yuhao-kuo/goose45/README.md

# Goose45

Goose45 is a 45% keyboard project.
