yuhao-kuo/goose45/case/goose45case_top_v10.FCStd

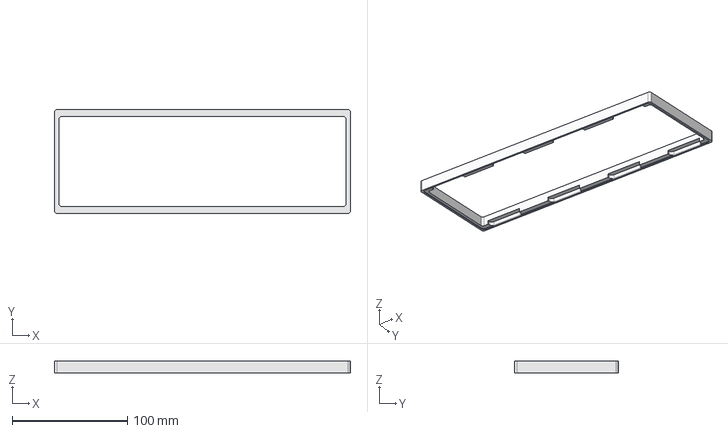
[picture p1: CAD file, 2023-12-30]
case/goose45case_top_v10.FCStd
257.0 x 90.0 x 10.0 mm
