yuhao-kuo/goose45/case/goose45case_class_v10.FCStd

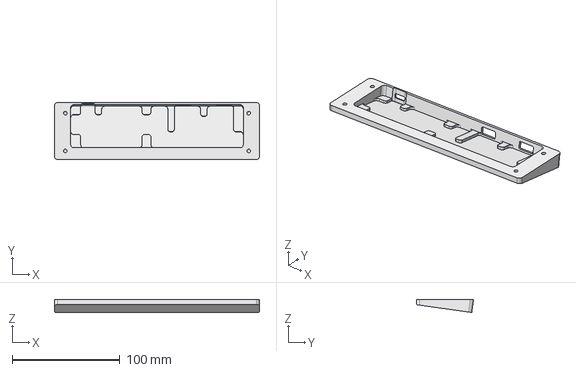
[picture p2: CAD file, 2023-12-30]
case/goose45case_class_v10.FCStd
190.0 x 53.0 x 12.0 mm
