yuhao-kuo/goose45/case/goose45case_bottom_v10.FCStd

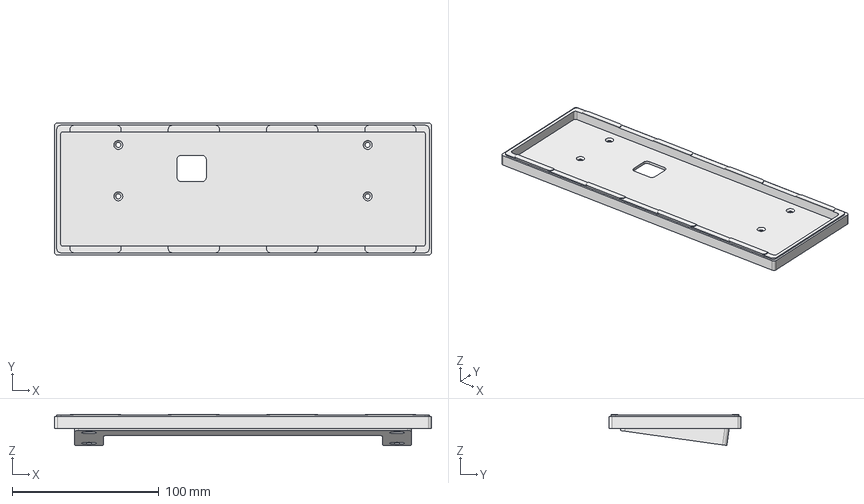
[picture p3: CAD file, 2023-12-30]
case/goose45case_bottom_v10.FCStd
257.0 x 90.0 x 21.2 mm
