yuhao-kuo/goose45/case/goose45case_plate_v10.FCStd

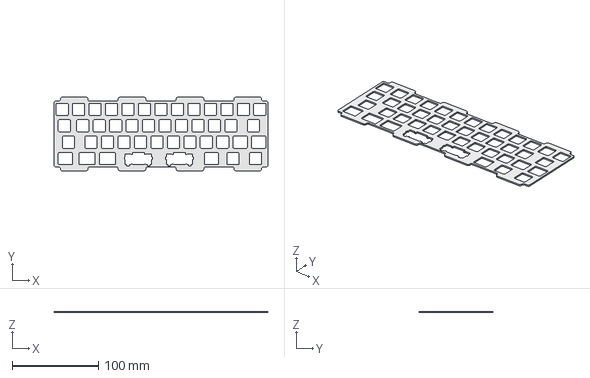
[picture p4: CAD file, 2023-12-30]
case/goose45case_plate_v10.FCStd
247.6 x 85.2 x 1.50 mm
