yuhao-kuo/goose45/case/goose45case_group.FCStd

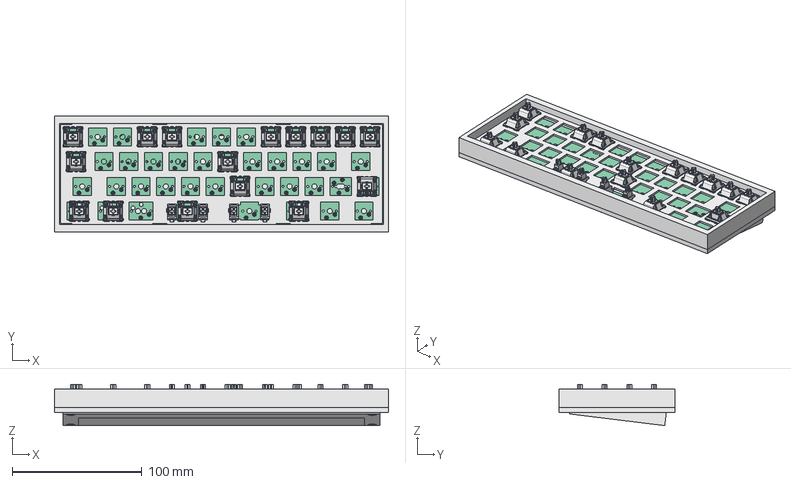
[picture p5: CAD file, 2023-02-15]
case/goose45case_group.FCStd
257.0 x 89.6 x 31.7 mm
Pcb_17d010
C6_C_1206_3216Metric_ad6b6205d722 x 4
R5_R_0603_1608Metric_66f7f9a4a4d005 x 4
C1_C_0603_1608Metric_e906ab7ae621 x 7
J2_Molex_53261_0571_cd36a31aba027 x 3
C13_CP_EIA_7343_30_AVX_N_2c1bf9caf20f001 x 4
USB Type C Port (SMD Type)067
USB Type C Port (SMD Type)059
USB Type C Port (SMD Type)048
USB Type C Port (SMD Type)061
USB Type C Port (SMD Type)062
USB Type C Port (SMD Type)060
USB Type C Port (SMD Type)063
USB Type C Port (SMD Type)055
USB Type C Port (SMD Type)054
USB Type C Port (SMD Type)069
USB Type C Port (SMD Type)068
USB Type C Port (SMD Type)051
USB Type C Port (SMD Type)050
USB Type C Port (SMD Type)049
USB Type C Port (SMD Type)070
USB Type C Port (SMD Type)071
USB Type C Port (SMD Type)065
USB Type C Port (SMD Type)066
USB Type C Port (SMD Type)056
USB Type C Port (SMD Type)057
USB Type C Port (SMD Type)058
USB Type C Port (SMD Type)052
USB Type C Port (SMD Type)053
USB Type C Port (SMD Type)064
HSG_Ĭɏ
U1_SSOP_28_39x99mm_P0635mm_da9d01e35b0a001
Pcb_8ee003
J1_USB1110-30-A_7d147ec46cc008 x 2
plate
Pcb_4af5
SW_Hotswap_Kailh_cp x 47
SW_Hotswap_Kailh_cp001 x 47
SW_Hotswap_Kailh_cp002 x 47
SW_Cherry_MX_Plate_cp x 16
SW_Cherry_MX_Plate_cp001 x 16
SW_Cherry_MX_Plate_cp002 x 16
SW_Cherry_MX_Plate_cp003 x 16
SW_Cherry_MX_Plate_cp004 x 16
SW_Cherry_MX_Plate_cp005 x 16
SW_Cherry_MX_Plate_cp006 x 16
Stabilizer_Cherry_MX_2u_cp x 2
Stabilizer_Cherry_MX_2u_cp001 x 2
Stabilizer_Cherry_MX_2u_cp002 x 2
Stabilizer_Cherry_MX_2u_cp003 x 2
Stabilizer_Cherry_MX_2u_cp004 x 2
top
class
bottom
