yuhao-kuo/goose45/case/goose45case_plate_v9.FCStd

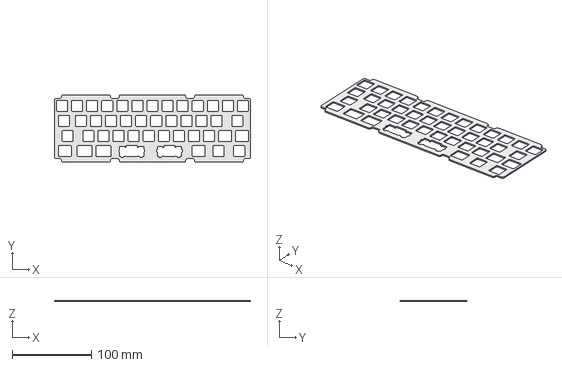
[picture p6: CAD file, 2023-05-23, an earlier design]
case/goose45case_plate_v9.FCStd
247.6 x 85.2 x 1.50 mm
