yuhao-kuo/goose45/case/goose45case_class_v9.FCStd

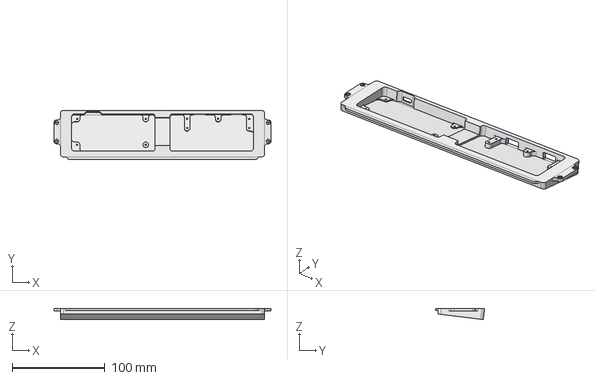
[picture p7: CAD file, 2023-04-01, an earlier design]
case/goose45case_class_v9.FCStd
234.0 x 53.2 x 12.0 mm
