yuhao-kuo/goose45/case/goose45case_top_v9.FCStd

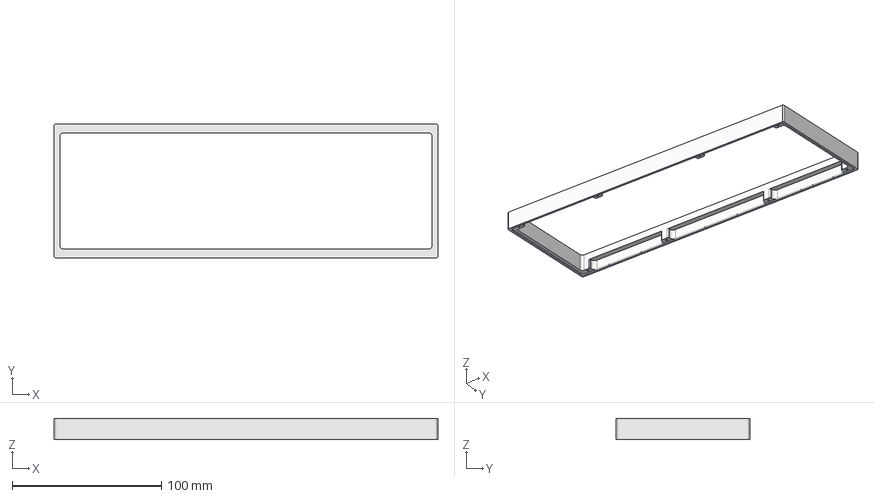
[picture p8: CAD file, 2023-04-01, an earlier design]
case/goose45case_top_v9.FCStd
257.0 x 89.5 x 14.1 mm
