yuhao-kuo/goose45/case/goose45case_bottom_v9.FCStd

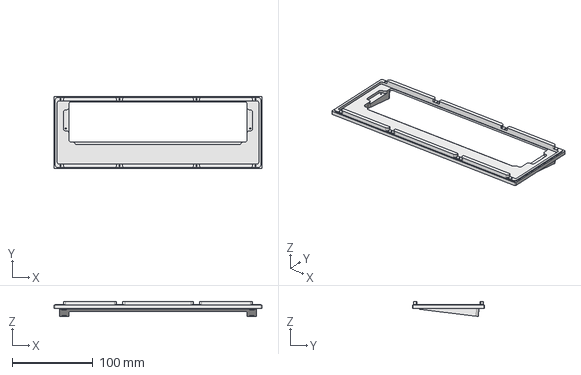
[picture p9: CAD file, 2023-04-01, an earlier design]
case/goose45case_bottom_v9.FCStd
257.0 x 89.6 x 18.5 mm
