yuhao-kuo/goose45/case/goose45case_class_v8.FCStd

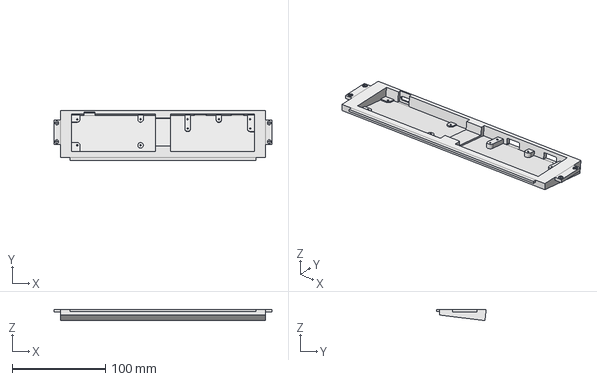
[picture p10: CAD file, 2023-03-04, an earlier design]
case/goose45case_class_v8.FCStd
234.0 x 53.2 x 12.0 mm
