yuhao-kuo/goose45/(list of files, cad)

Other CAD files:
case/goose45case_top_v7.FCStd
case/goose45case_class_v7.FCStd
case/goose45case_plate_v7.FCStd
case/goose45case_bottom_v7.FCStd
