yuhao-kuo/goose45/(threads)

Thread 1 (2023-02-06):

Warning - USB Port PCB differential pairs length isn't same

tw1chao, 2023-02-06:
Reference this ["Kicad route differentil pairs"](https://www.protoexpress.com/blog/how-to-route-differential-pairs-in-kicad/)

The "D-" trace total length is 21.3255mm
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

The "D+" trace total length 19.4638mm
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
