yuhao-kuo/goose45/usbhub2.0rev2/usbhub2.0.kicad_pcb

## KiCad design usbhub2.0rev2/usbhub2.0.kicad_pcb (2023-12-30)

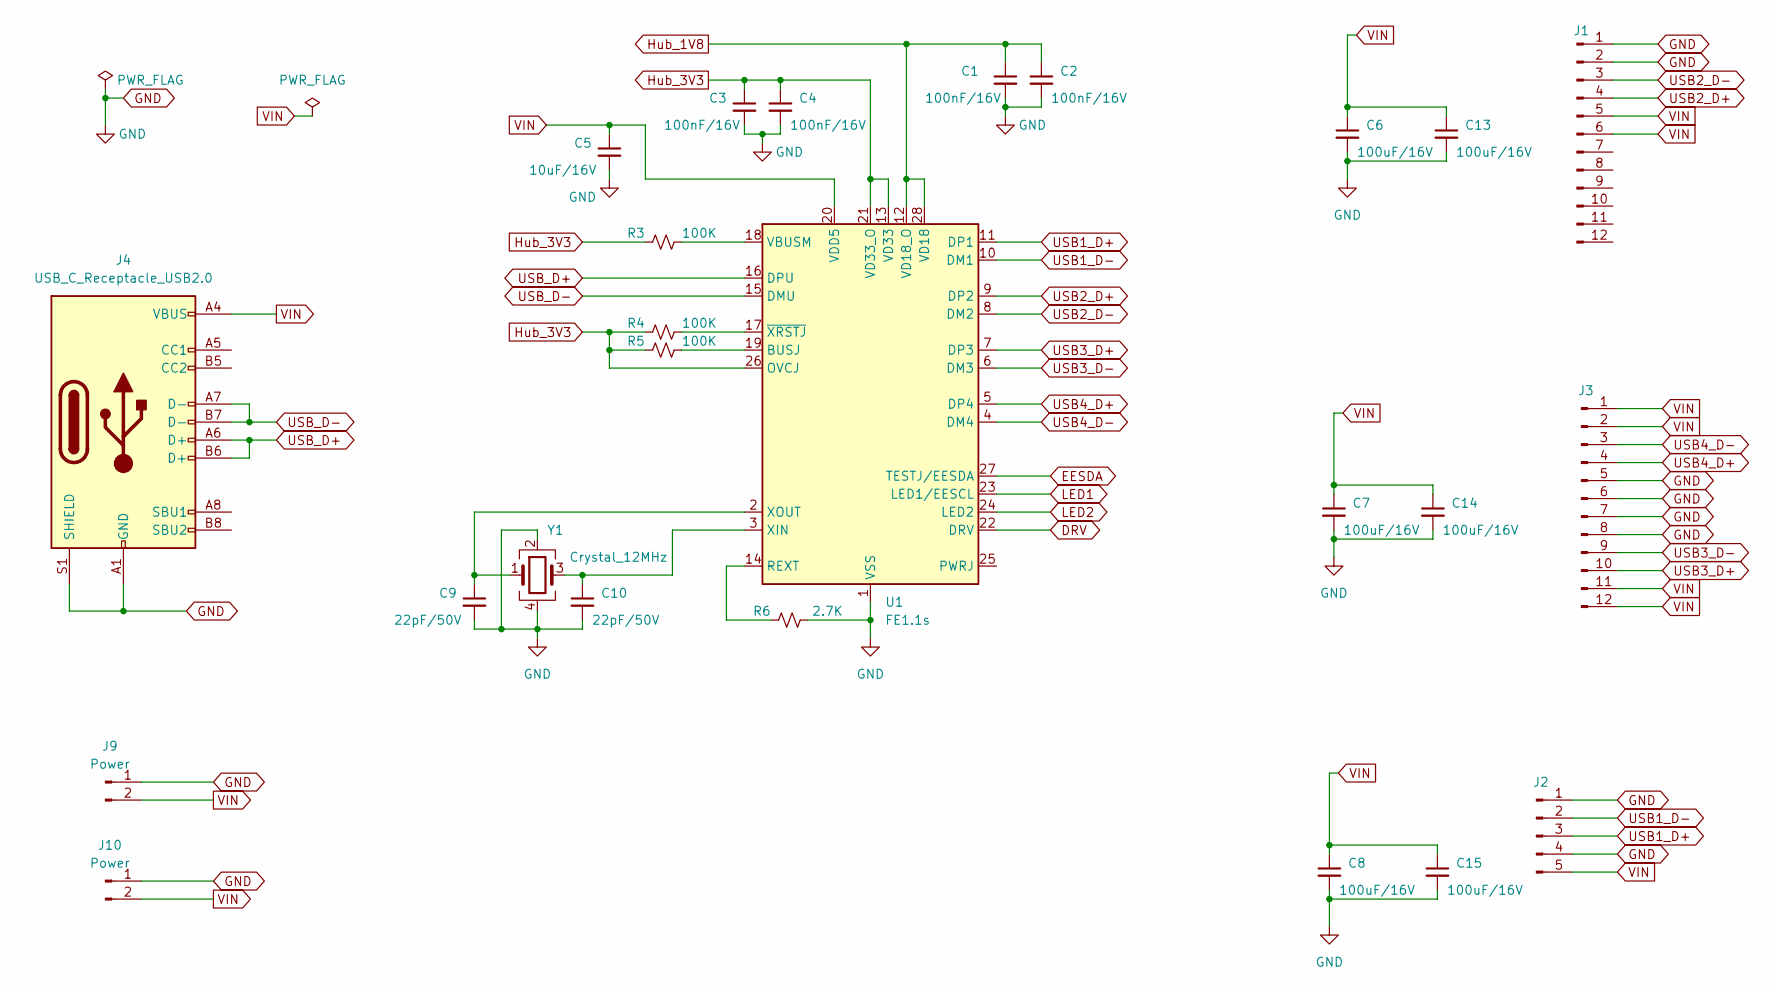
[picture p11: schematic usbhub2.0.kicad_sch]

Parts:
C1, C2, C3, C4: 100nF/16V; C_0603_1608Metric
C5: 10uF/16V; C_0603_1608Metric
C6, C7, C8: 100uF/16V; C_1206_3216Metric
C9, C10: 22pF/50V; C_0603_1608Metric
C13, C14, C15: 100uF/16V; CP_EIA-7343-30_AVX-N_Pad2.25x2.55mm_HandSolder
J1, J3: Conn_01x12_Pin; Hirose_FH12-12S-0.5SH_1x12-1MP_P0.50mm_Horizontal
J2: Conn_01x05_Male; PinHeader_1x05_P2.54mm_Vertical
J4: USB_C_Receptacle_USB2.0; USB_C_Receptacle_HRO_TYPE-C-31-M-12
J9, J10: Power; PinHeader_1x02_P2.54mm_Vertical
R3, R4, R5: 100K; R_0603_1608Metric
R6: 2.7K; R_0603_1608Metric
U1: FE1.1s; SSOP-28_3.9x9.9mm_P0.635mm
Y1: Crystal_12MHz; Crystal_SMD_Abracon_ABM3C-4Pin_5.0x3.2mm

Connections:
DRV: U1.22 (DRV)
EESDA: U1.27 (TESTJ/EESDA)
GND: C1.2, C2.2, C3.2, C4.2, C5.2, C6.2, C7.2, C8.2, C9.2, C10.2, C13.2, C14.2, C15.2, J1.1, J1.2, J2.1, J2.4, J3.5, J3.6, J3.7, J3.8, J4.A1 (GND), J4.A12 (GND), J4.B1 (GND), J4.B12 (GND), J4.S1 (SHIELD), J9.1, J10.1, R6.2, U1.1 (VSS), Y1.2, Y1.4
Hub_1V8: C1.1, C2.1, U1.12 (VD18_O), U1.28 (VD18)
Hub_3V3: C3.1, C4.1, R3.1, R4.1, R5.1, U1.13 (VD33), U1.21 (VD33_O), U1.26 (OVCJ)
LED1: U1.23 (LED1/EESCL)
LED2: U1.24 (LED2)
unnamed: R5.2, U1.19 (BUSJ)
unnamed: R6.1, U1.14 (REXT)
unnamed: R3.2, U1.18 (VBUSM)
unnamed: C10.1, U1.3 (XIN), Y1.3
unnamed: C9.1, U1.2 (XOUT), Y1.1
unnamed: R4.2, U1.17 (~XRSTJ)
USB1_D+: J2.3, U1.11 (DP1)
USB1_D-: J2.2, U1.10 (DM1)
USB2_D+: J1.4, U1.9 (DP2)
USB2_D-: J1.3, U1.8 (DM2)
USB3_D+: J3.10, U1.7 (DP3)
USB3_D-: J3.9, U1.6 (DM3)
USB4_D+: J3.4, U1.5 (DP4)
USB4_D-: J3.3, U1.4 (DM4)
USB_D+: J4.A6 (D+), J4.B6 (D+), U1.16 (DPU)
USB_D-: J4.A7 (D-), J4.B7 (D-), U1.15 (DMU)
VIN: C5.1, C6.1, C7.1, C8.1, C13.1, C14.1, C15.1, J1.5, J1.6, J2.5, J3.1, J3.2, J3.11, J3.12, J4.A4 (VBUS), J4.A9 (VBUS), J4.B4 (VBUS), J4.B9 (VBUS), J9.2, J10.2, U1.20 (VDD5)

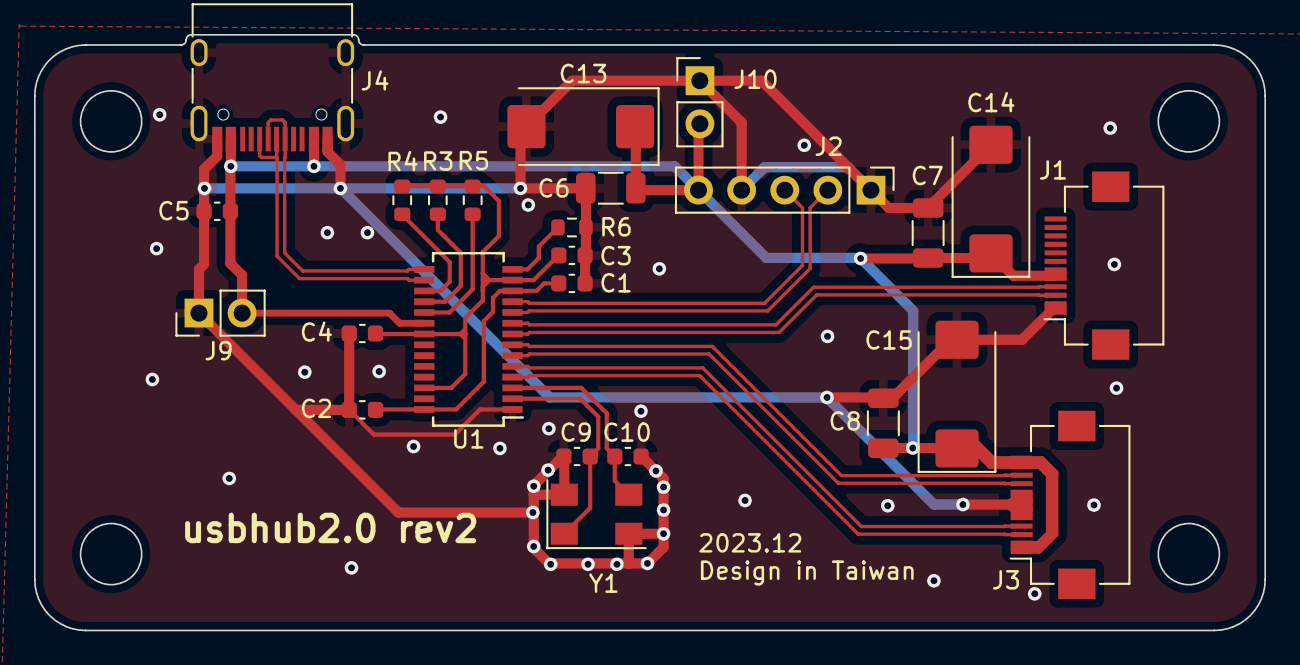
[picture p12: board usbhub2.0rev2/usbhub2.0.kicad_pcb from above]

Board: 2 copper layers, 72.5 x 35.1 mm, 25 parts (0 on the bottom side), 20 nets.
