yuhao-kuo/goose45/usbportrev2/usbport.kicad_pcb

## KiCad design usbportrev2/usbport.kicad_pcb (2023-12-30)

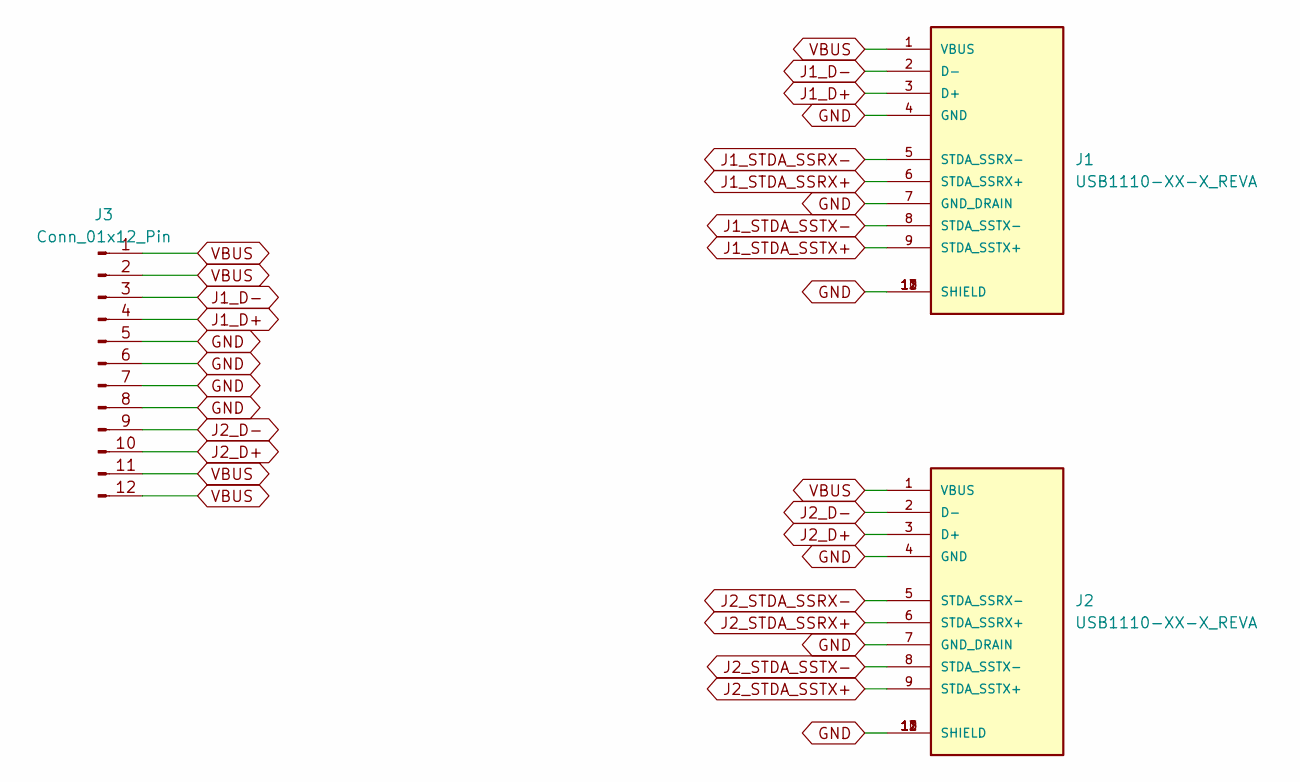
[picture p13: schematic usbport.kicad_sch]

Parts:
J1, J2: USB1110-XX-X_REVA; GCT_USB1110_goose45_usbport
J3: Conn_01x12_Pin; Hirose_FH12-12S-0.5SH_1x12-1MP_P0.50mm_Horizontal

Connections:
GND: J1.4 (GND), J1.7 (GND_DRAIN), J1.10 (SHIELD), J1.11 (SHIELD), J1.12 (SHIELD), J1.13 (SHIELD), J2.4 (GND), J2.7 (GND_DRAIN), J2.10 (SHIELD), J2.11 (SHIELD), J2.12 (SHIELD), J2.13 (SHIELD), J3.5, J3.6, J3.7, J3.8
J1_D+: J1.3 (D+), J3.4
J1_D-: J1.2 (D-), J3.3
J1_STDA_SSRX+: J1.6 (STDA_SSRX+)
J1_STDA_SSRX-: J1.5 (STDA_SSRX-)
J1_STDA_SSTX+: J1.9 (STDA_SSTX+)
J1_STDA_SSTX-: J1.8 (STDA_SSTX-)
J2_D+: J2.3 (D+), J3.10
J2_D-: J2.2 (D-), J3.9
J2_STDA_SSRX+: J2.6 (STDA_SSRX+)
J2_STDA_SSRX-: J2.5 (STDA_SSRX-)
J2_STDA_SSTX+: J2.9 (STDA_SSTX+)
J2_STDA_SSTX-: J2.8 (STDA_SSTX-)
VBUS: J1.1 (VBUS), J2.1 (VBUS), J3.1, J3.2, J3.11, J3.12

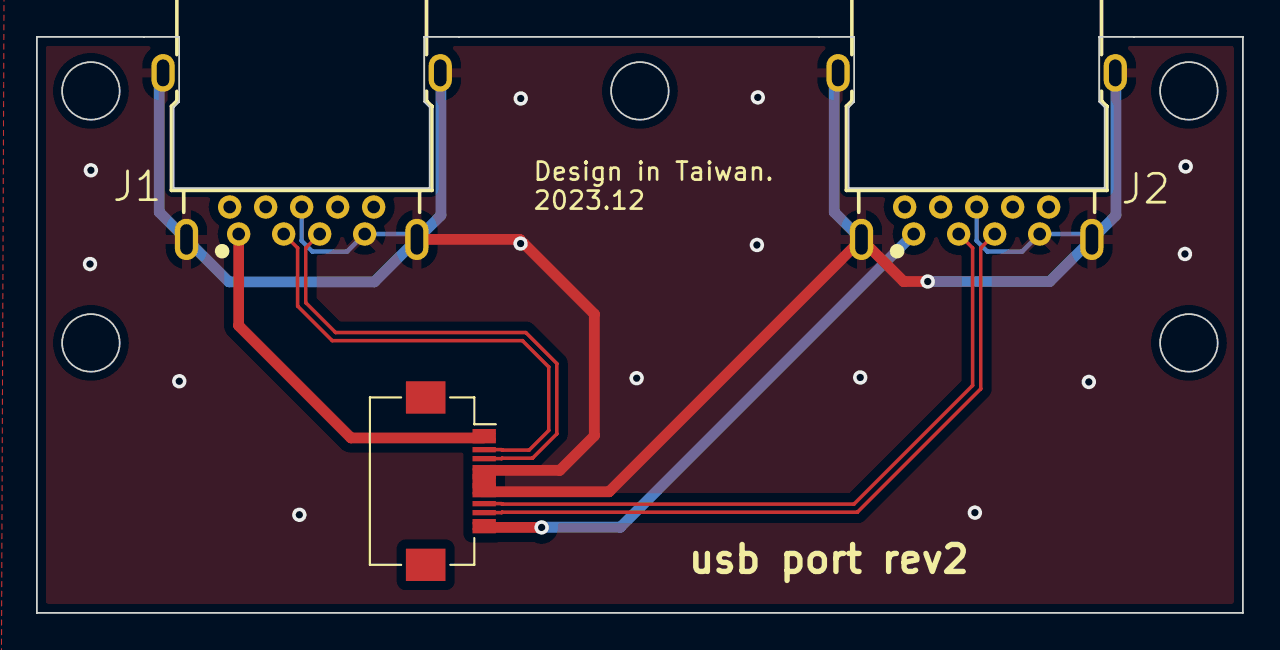
[picture p14: board usbport.kicad_pcb from above]

Board: 2 copper layers, 67.0 x 32.0 mm, 3 parts (0 on the bottom side), 6 nets.
