yuhao-kuo/goose45/goose45rev3/goose45.kicad_pcb

## KiCad design goose45rev3/goose45.kicad_pcb (2023-12-09)

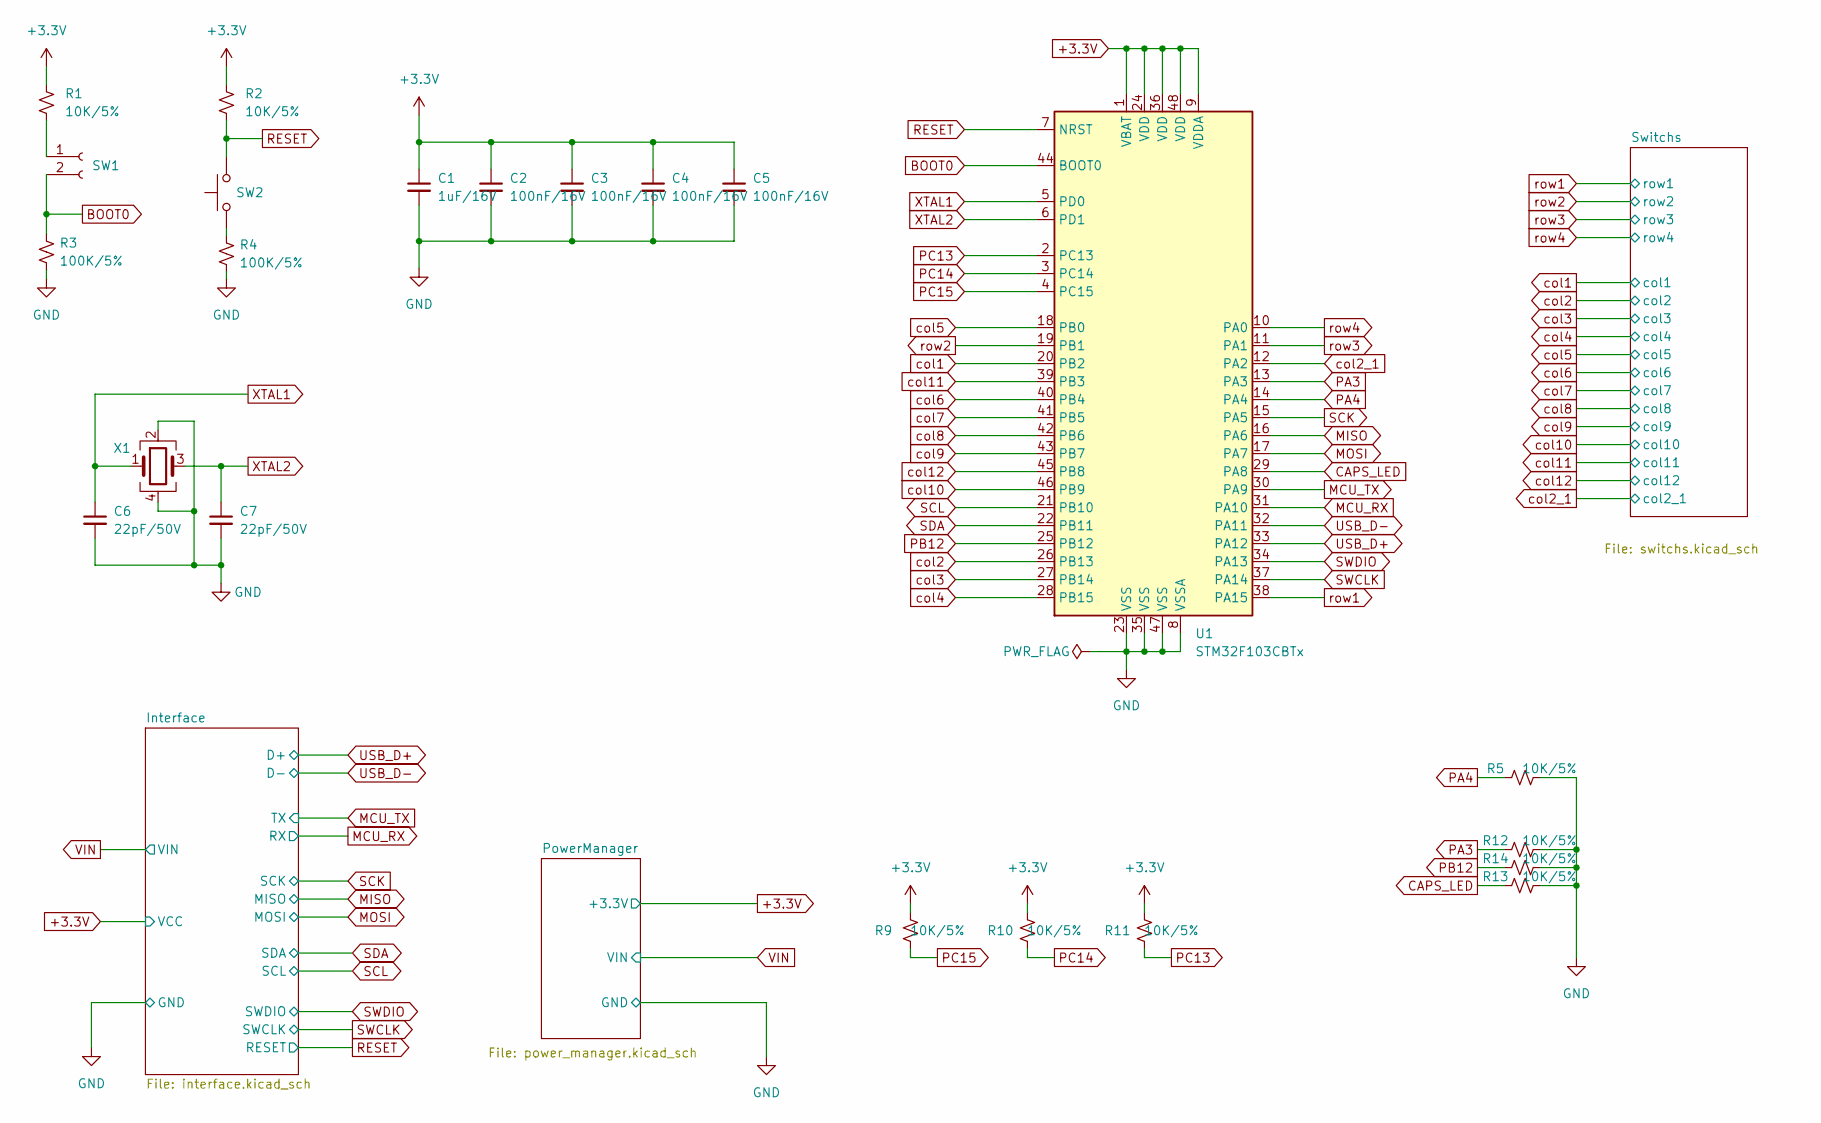
[picture p15: schematic goose45.kicad_sch]

Parts:
C1: 1uF/16V; C_0603_1608Metric
C2, C3, C4, C5: 100nF/16V; C_0603_1608Metric
C6, C7: 22pF/50V; C_0603_1608Metric
R1, R2, R5, R9, R10, R11, R12, R13, R14: 10K/5%; R_0603_1608Metric
R3, R4: 100K/5%; R_0603_1608Metric
SW1: Conn_01x02_Female; PinHeader_1x02_P2.00mm_Vertical
SW2: SW_Push; SW_Push_1P1T_NO_CK_KSC6xxJ
U1: STM32F103CBTx; LQFP-48_7x7mm_P0.5mm
X1: Crystal_GND24; Crystal_SMD_TXC_7M-4Pin_3.2x2.5mm

Connections:
+3.3V: C1.1, C2.1, C3.1, C4.1, C5.1, R1.1, R2.1, R9.1, R10.1, R11.1, U1.1 (VBAT), U1.9 (VDDA), U1.24 (VDD), U1.36 (VDD), U1.48 (VDD); also elsewhere on the board
BOOT0: R3.1, SW1.2, U1.44 (BOOT0)
CAPS_LED: R13.2, U1.29 (PA8)
GND: C1.2, C2.2, C3.2, C4.2, C5.2, C6.2, C7.2, R3.2, R4.2, R5.1, R12.1, R13.1, R14.1, U1.8 (VSSA), U1.23 (VSS), U1.35 (VSS), U1.47 (VSS), X1.2, X1.4; also elsewhere on the board
MCU_RX: U1.31 (PA10); also elsewhere on the board
MCU_TX: U1.30 (PA9); also elsewhere on the board
MISO: U1.16 (PA6); also elsewhere on the board
MOSI: U1.17 (PA7); also elsewhere on the board
unnamed: R4.1, SW2.1
unnamed: R1.2, SW1.1
PA3: R12.2, U1.13 (PA3)
PA4: R5.2, U1.14 (PA4)
PB12: R14.2, U1.25 (PB12)
PC13: R11.2, U1.2 (PC13)
PC14: R10.2, U1.3 (PC14)
PC15: R9.2, U1.4 (PC15)
RESET: R2.2, SW2.2, U1.7 (NRST); also elsewhere on the board
SCK: U1.15 (PA5); also elsewhere on the board
SCL: U1.21 (PB10); also elsewhere on the board
SDA: U1.22 (PB11); also elsewhere on the board
SWCLK: U1.37 (PA14); also elsewhere on the board
SWDIO: U1.34 (PA13); also elsewhere on the board
USB_D+: U1.33 (PA12); also elsewhere on the board
USB_D-: U1.32 (PA11); also elsewhere on the board
XTAL1: C6.1, U1.5 (PD0), X1.1
XTAL2: C7.1, U1.6 (PD1), X1.3
col1: U1.20 (PB2); also elsewhere on the board
col2: U1.26 (PB13); also elsewhere on the board
col2_1: U1.12 (PA2); also elsewhere on the board
col3: U1.27 (PB14); also elsewhere on the board
col4: U1.28 (PB15); also elsewhere on the board
col5: U1.18 (PB0); also elsewhere on the board
col6: U1.40 (PB4); also elsewhere on the board
col7: U1.41 (PB5); also elsewhere on the board
col8: U1.42 (PB6); also elsewhere on the board
col9: U1.43 (PB7); also elsewhere on the board
col10: U1.46 (PB9); also elsewhere on the board
col11: U1.39 (PB3); also elsewhere on the board
col12: U1.45 (PB8); also elsewhere on the board
row1: U1.38 (PA15); also elsewhere on the board
row2: U1.19 (PB1); also elsewhere on the board
row3: U1.11 (PA1); also elsewhere on the board
row4: U1.10 (PA0); also elsewhere on the board

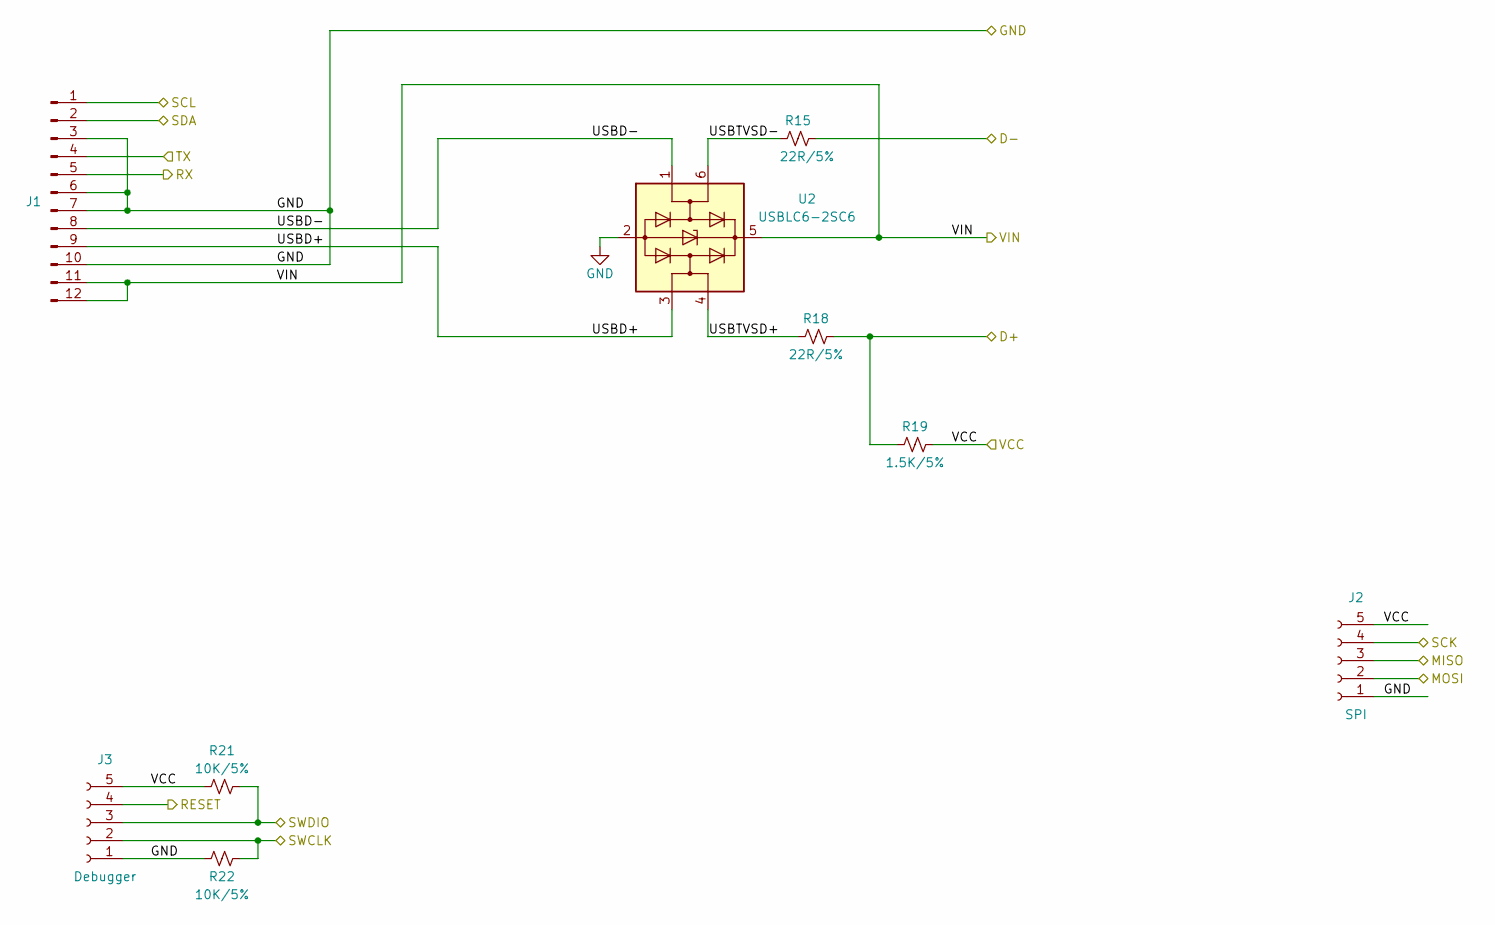
[picture p16: schematic interface.kicad_sch]

Parts:
J1: USB connector; Hirose_FH12-12S-0.5SH_1x12-1MP_P0.50mm_Horizontal
J2: SPI; PinHeader_1x05_P2.00mm_Vertical
J3: Debugger; PinHeader_1x05_P2.00mm_Vertical
R15, R18: 22R/5%; R_0603_1608Metric
R19: 1.5K/5%; R_0603_1608Metric
R21, R22: 10K/5%; R_0603_1608Metric
U2: USBLC6-2SC6; SOT-23-6

Connections:
+3.3V: J2.5, J3.5, R19.2, R21.1; also elsewhere on the board
/Interface/USBD+: J1.9, U2.3 (I/O2)
/Interface/USBD-: J1.8, U2.1 (I/O1)
/Interface/USBTVSD+: R18.1, U2.4 (I/O2)
/Interface/USBTVSD-: R15.1, U2.6 (I/O1)
GND: J1.3, J1.6, J1.7, J1.10, J2.1, J3.1, R22.1, U2.2 (GND); also elsewhere on the board
MCU_RX: J1.5; also elsewhere on the board
MCU_TX: J1.4; also elsewhere on the board
MISO: J2.3; also elsewhere on the board
MOSI: J2.2; also elsewhere on the board
RESET: J3.4; also elsewhere on the board
SCK: J2.4; also elsewhere on the board
SCL: J1.1; also elsewhere on the board
SDA: J1.2; also elsewhere on the board
SWCLK: J3.2, R22.2; also elsewhere on the board
SWDIO: J3.3, R21.2; also elsewhere on the board
USB_D+: R18.2, R19.1; also elsewhere on the board
USB_D-: R15.2; also elsewhere on the board
VIN: J1.11, J1.12, U2.5 (VBUS); also elsewhere on the board

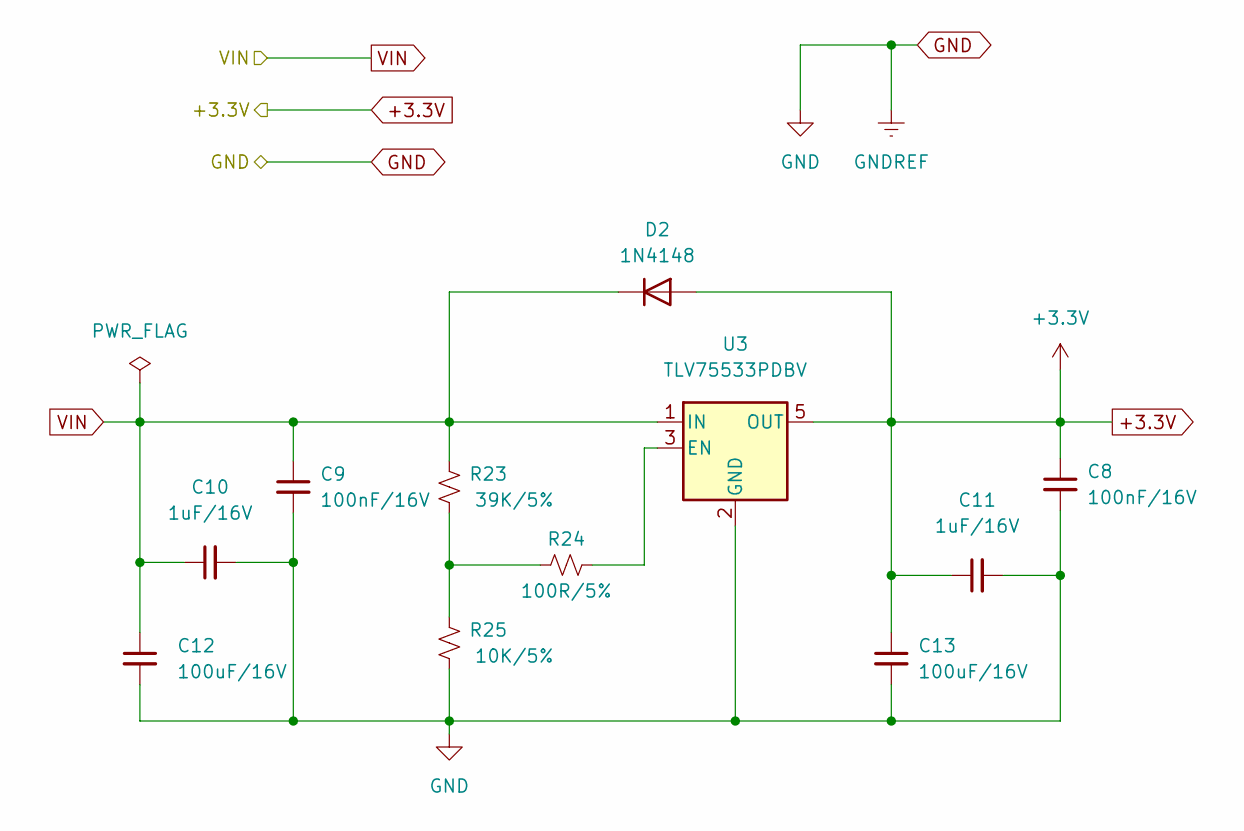
[picture p17: schematic power_manager.kicad_sch]

Parts:
C8, C9: 100nF/16V; C_0603_1608Metric
C10, C11: 1uF/16V; C_0603_1608Metric
C12, C13: 100uF/16V; C_0603_1608Metric
D2: 1N4148; D_SOD-323
R23: 39K/5%; R_0603_1608Metric
R24: 100R/5%; R_0603_1608Metric
R25: 10K/5%; R_0603_1608Metric
U3: TLV75533PDBV; SOT-23-5

Connections:
+3.3V: C8.1, C11.1, C13.1, D2.2 (A), U3.5 (OUT); also elsewhere on the board
GND: C8.2, C9.2, C10.2, C11.2, C12.2, C13.2, R25.2, U3.2 (GND); also elsewhere on the board
unnamed: R23.1, R24.2, R25.1
unnamed: R24.1, U3.3 (EN)
VIN: C9.1, C10.1, C12.1, D2.1 (K), R23.2, U3.1 (IN); also elsewhere on the board

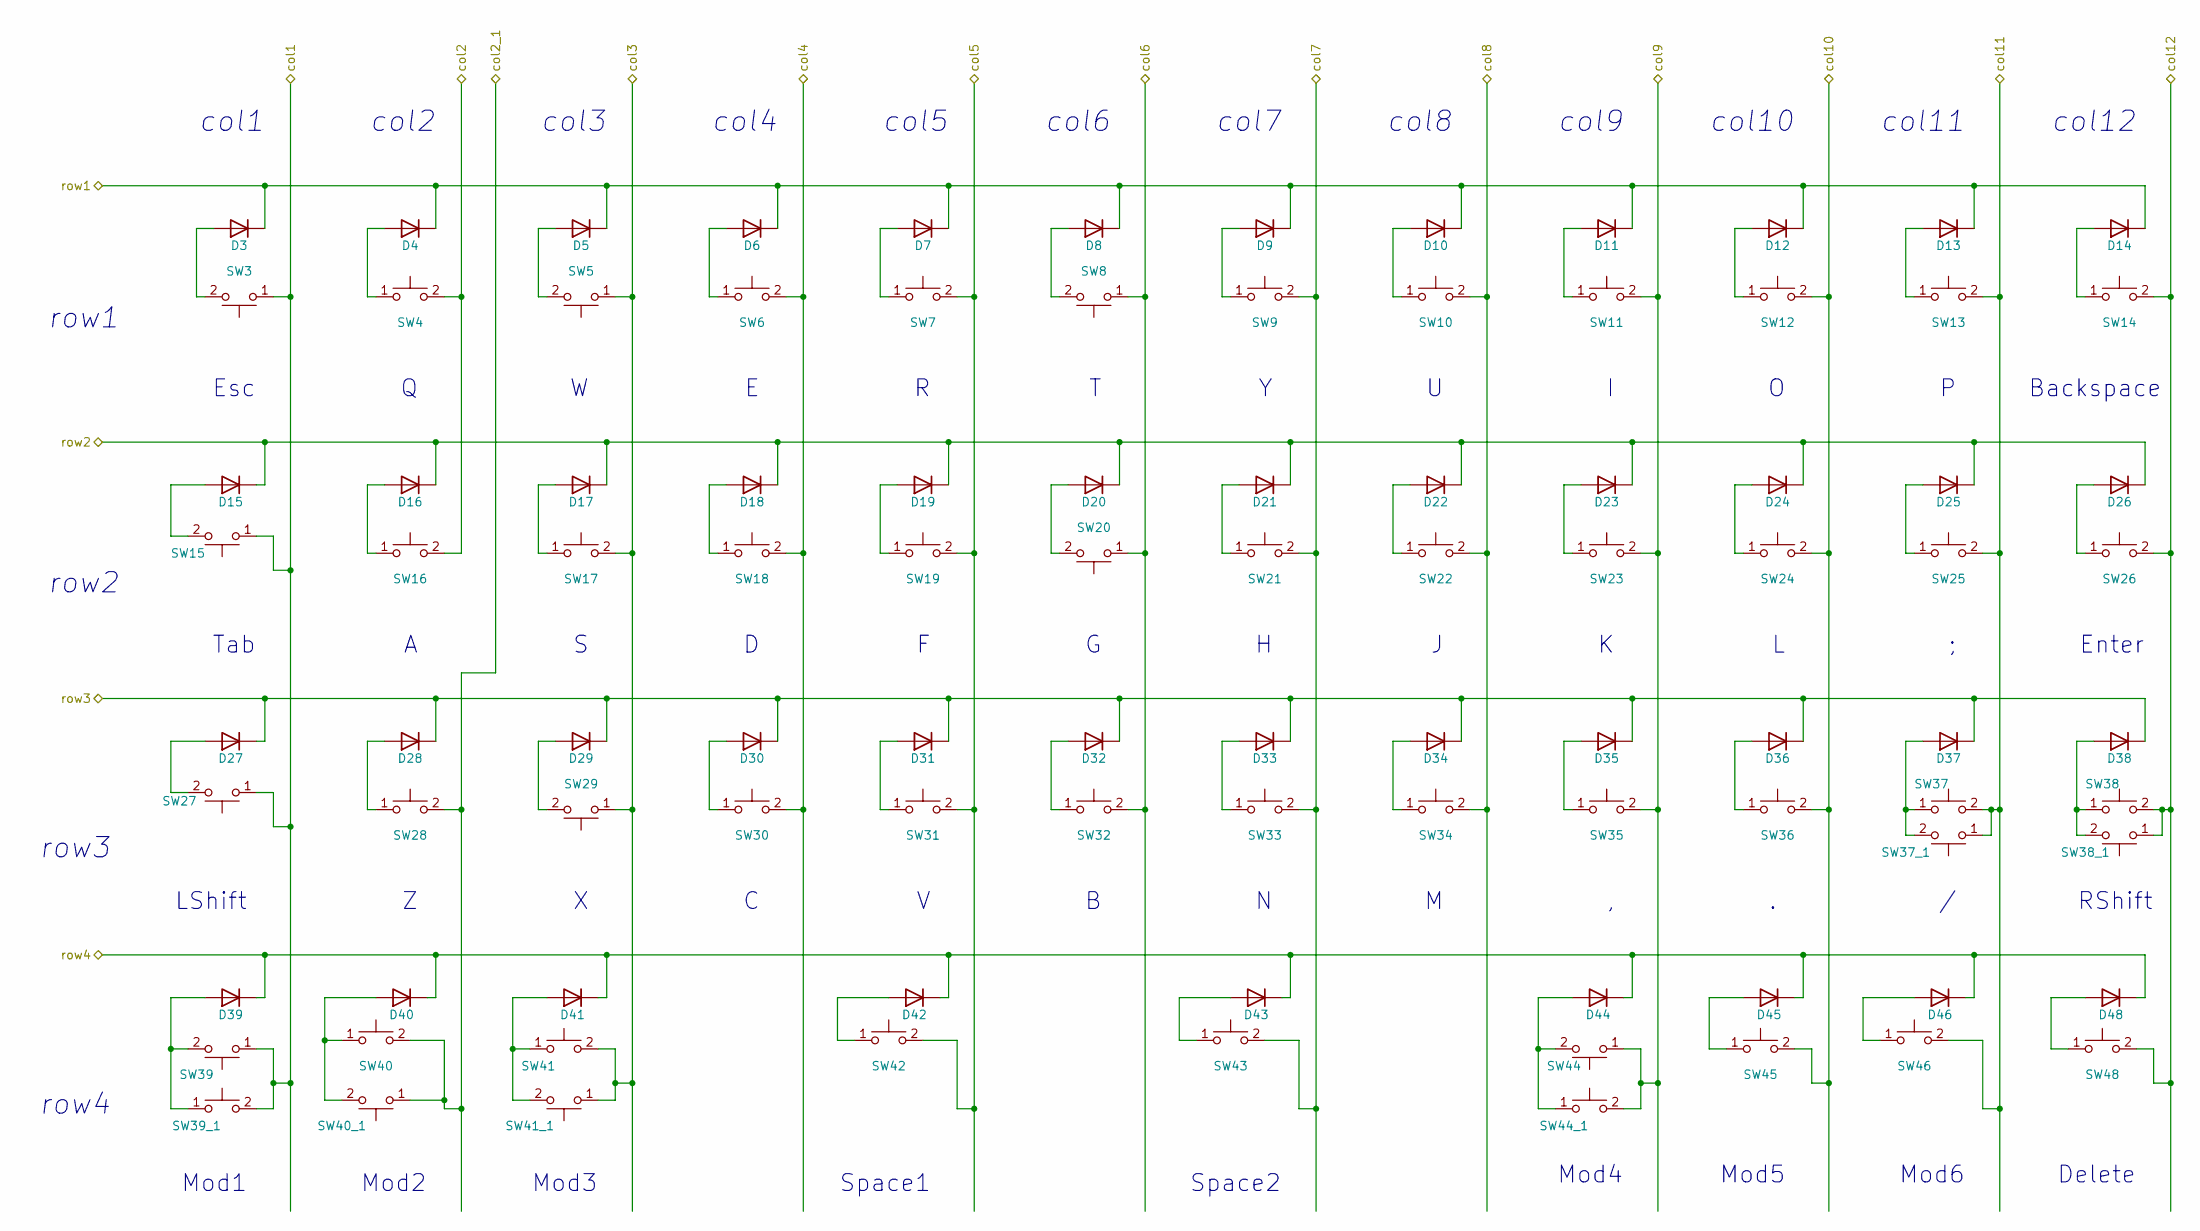
[picture p18: schematic switchs.kicad_sch]

Parts:
D3, D4, D5, D6, D7, D8, D9, D10, D11, D12, D13, D14, D15, D16, D17, D18, D19, D20, D21, D22, D23, D24, D25, D26, D27, D28, D29, D30, D31, D32, D33, D34, D35, D36, D37, D38, D39, D40, D41, D42, D43, D44, D45, D46, D48: 1N4148; D_SOD-323
SW3, SW4, SW5, SW6, SW7, SW8, SW9, SW10, SW11, SW12, SW13, SW14, SW15, SW16, SW17, SW18, SW19, SW20, SW21, SW22, SW23, SW24, SW25, SW26, SW27, SW28, SW29, SW30, SW31, SW32, SW33, SW34, SW35, SW36, SW37, SW37_1, SW38, SW38_1, SW39, SW39_1, SW40, SW40_1, SW41, SW41_1, SW42, SW43, SW44, SW44_1, SW45, SW46, SW48: SW_Push; SW_Hotswap_Kailh_MX

Connections:
unnamed: D3.2 (A), SW3.2
unnamed: D4.2 (A), SW4.1
unnamed: D5.2 (A), SW5.2
unnamed: D6.2 (A), SW6.1
unnamed: D7.2 (A), SW7.1
unnamed: D8.2 (A), SW8.2
unnamed: D9.2 (A), SW9.1
unnamed: D10.2 (A), SW10.1
unnamed: D11.2 (A), SW11.1
unnamed: D12.2 (A), SW12.1
unnamed: D13.2 (A), SW13.1
unnamed: D14.2 (A), SW14.1
unnamed: D15.2 (A), SW15.2
unnamed: D16.2 (A), SW16.1
unnamed: D17.2 (A), SW17.1
unnamed: D18.2 (A), SW18.1
unnamed: D19.2 (A), SW19.1
unnamed: D20.2 (A), SW20.2
unnamed: D21.2 (A), SW21.1
unnamed: D22.2 (A), SW22.1
unnamed: D23.2 (A), SW23.1
unnamed: D24.2 (A), SW24.1
unnamed: D25.2 (A), SW25.1
unnamed: D26.2 (A), SW26.1
unnamed: D27.2 (A), SW27.2
unnamed: D28.2 (A), SW28.1
unnamed: D29.2 (A), SW29.2
unnamed: D30.2 (A), SW30.1
unnamed: D31.2 (A), SW31.1
unnamed: D32.2 (A), SW32.1
unnamed: D33.2 (A), SW33.1
unnamed: D34.2 (A), SW34.1
unnamed: D35.2 (A), SW35.1
unnamed: D36.2 (A), SW36.1
unnamed: D37.2 (A), SW37.1, SW37_1.2
unnamed: D38.2 (A), SW38.1, SW38_1.2
unnamed: D39.2 (A), SW39.2, SW39_1.1
unnamed: D40.2 (A), SW40.1, SW40_1.2
unnamed: D41.2 (A), SW41.1, SW41_1.2
unnamed: D42.2 (A), SW42.1
unnamed: D43.2 (A), SW43.1
unnamed: D44.2 (A), SW44.2, SW44_1.1
unnamed: D45.2 (A), SW45.1
unnamed: D46.2 (A), SW46.1
unnamed: D48.2 (A), SW48.1
col1: SW3.1, SW15.1, SW27.1, SW39.1, SW39_1.2; also elsewhere on the board
col2: SW4.2, SW16.2; also elsewhere on the board
col2_1: SW28.2, SW40.2, SW40_1.1; also elsewhere on the board
col3: SW5.1, SW17.2, SW29.1, SW41.2, SW41_1.1; also elsewhere on the board
col4: SW6.2, SW18.2, SW30.2; also elsewhere on the board
col5: SW7.2, SW19.2, SW31.2, SW42.2; also elsewhere on the board
col6: SW8.1, SW20.1, SW32.2; also elsewhere on the board
col7: SW9.2, SW21.2, SW33.2, SW43.2; also elsewhere on the board
col8: SW10.2, SW22.2, SW34.2; also elsewhere on the board
col9: SW11.2, SW23.2, SW35.2, SW44.1, SW44_1.2; also elsewhere on the board
col10: SW12.2, SW24.2, SW36.2, SW45.2; also elsewhere on the board
col11: SW13.2, SW25.2, SW37.2, SW37_1.1, SW46.2; also elsewhere on the board
col12: SW14.2, SW26.2, SW38.2, SW38_1.1, SW48.2; also elsewhere on the board
row1: D3.1 (K), D4.1 (K), D5.1 (K), D6.1 (K), D7.1 (K), D8.1 (K), D9.1 (K), D10.1 (K), D11.1 (K), D12.1 (K), D13.1 (K), D14.1 (K); also elsewhere on the board
row2: D15.1 (K), D16.1 (K), D17.1 (K), D18.1 (K), D19.1 (K), D20.1 (K), D21.1 (K), D22.1 (K), D23.1 (K), D24.1 (K), D25.1 (K), D26.1 (K); also elsewhere on the board
row3: D27.1 (K), D28.1 (K), D29.1 (K), D30.1 (K), D31.1 (K), D32.1 (K), D33.1 (K), D34.1 (K), D35.1 (K), D36.1 (K), D37.1 (K), D38.1 (K); also elsewhere on the board
row4: D39.1 (K), D40.1 (K), D41.1 (K), D42.1 (K), D43.1 (K), D44.1 (K), D45.1 (K), D46.1 (K), D48.1 (K); also elsewhere on the board

Notes on the sheet:
Backspace
col7
col8
col9
Mod1
col12
col2
Space2
Mod5
Tab
col11
LShift
row2
Mod4
Mod2
col5
Delete
Mod6
col10
row3
RShift
col1
Esc
col3
col4
row1
Enter
col6
Mod3
row4
Space1

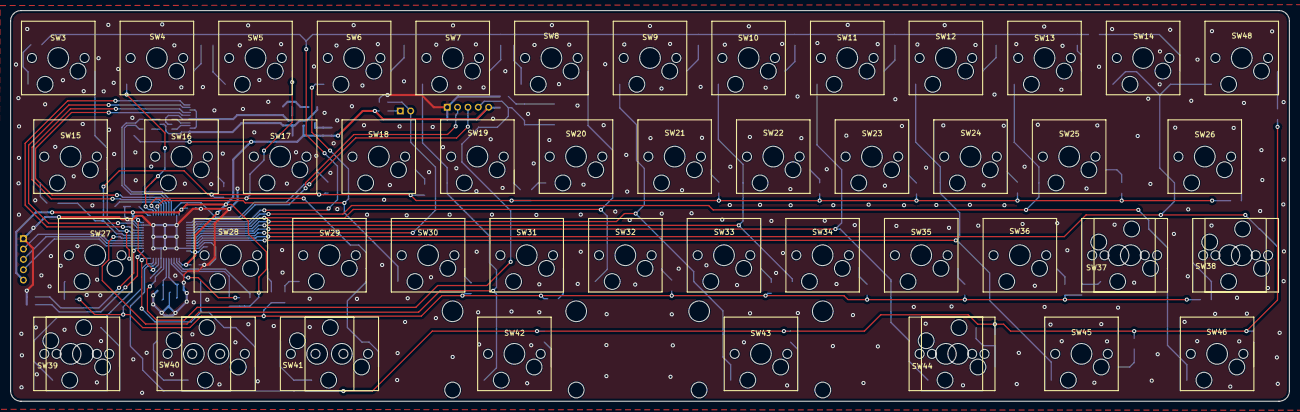
[picture p19: board goose45.kicad_pcb from above]

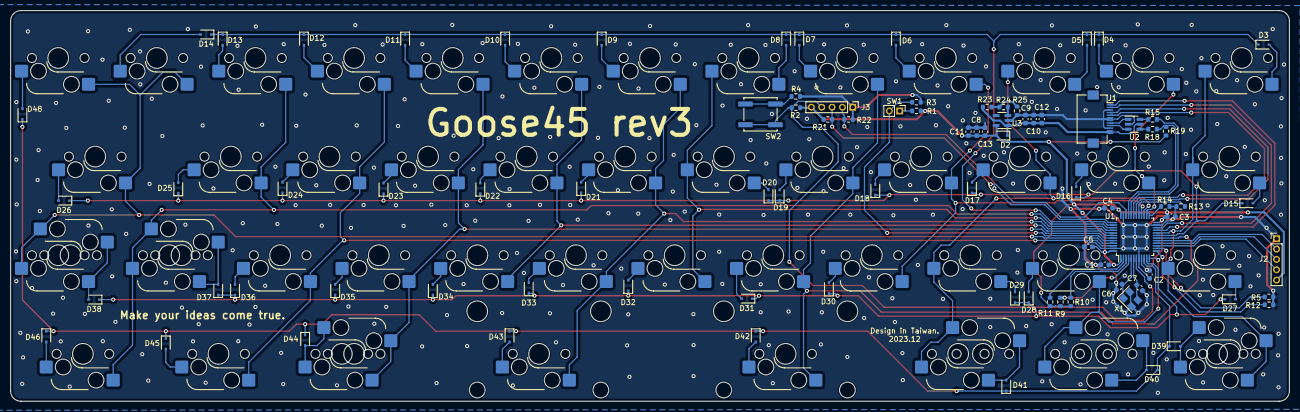
[picture p20: board goose45.kicad_pcb from below]

Board: 2 copper layers, 247.0 x 75.4 mm, 140 parts (87 on the bottom side), 95 nets.

Other parts of the board:
REF1, REF2: Stabilizer_Cherry_MX_2.00u
