yuhao-kuo/goose45/usbhub2.0/usbhub2.0.kicad_pcb

## KiCad design usbhub2.0/usbhub2.0.kicad_pcb (continued)

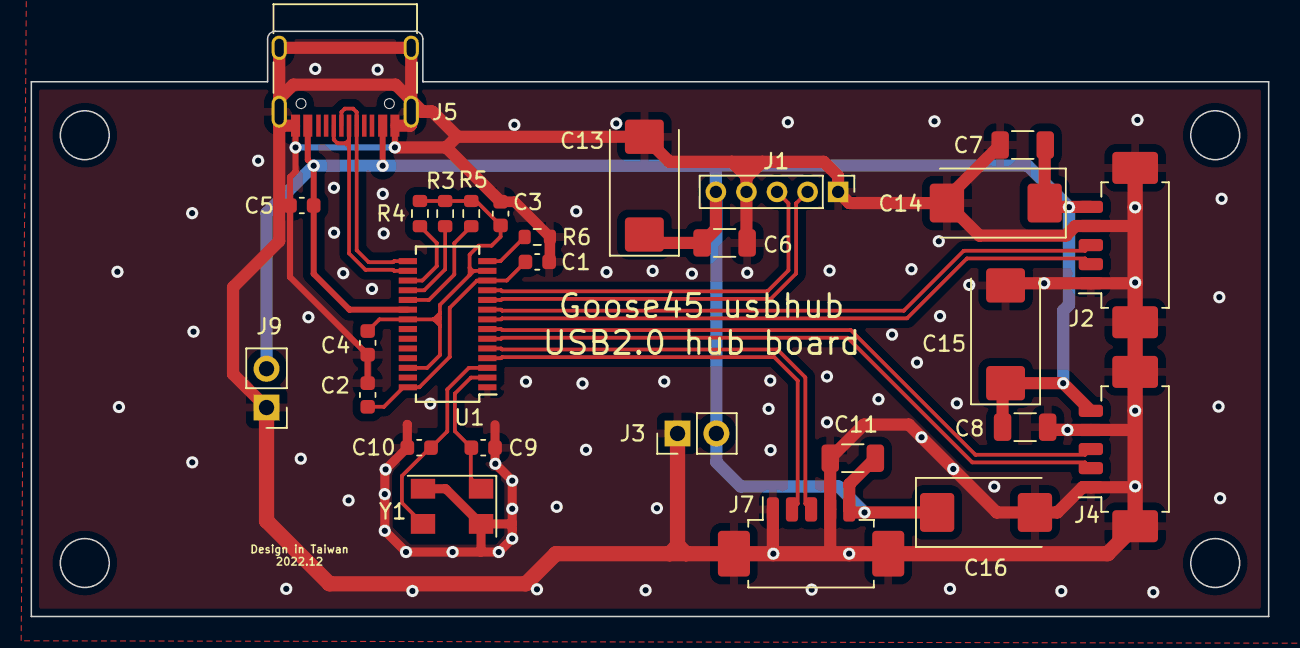
[picture p22: board usbhub2.0/usbhub2.0.kicad_pcb from above]

Board: 2 copper layers, 81.0 x 38.3 mm, 28 parts (0 on the bottom side), 20 nets.
