yuhao-kuo/goose45/onekeymod1u/onekeymod1u.kicad_pcb

## KiCad design onekeymod1u/onekeymod1u.kicad_pcb (2022-11-12)

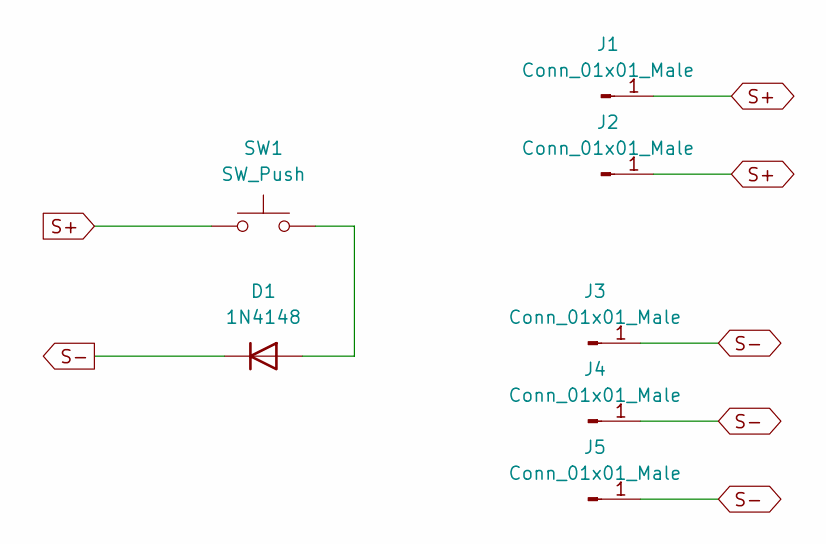
[picture p23: schematic onekeymod1u.kicad_sch]

Parts:
D1: 1N4148; D_SOD-323
J1, J2, J3, J4, J5: Conn_01x01_Male; PinSocket_1x01_P2.00mm_Vertical
SW1: SW_Push; SW_Hotswap_Kailh_MX

Connections:
unnamed: D1.2 (A), SW1.2
S+: J1.1, J2.1, SW1.1
S-: D1.1 (K), J3.1, J4.1, J5.1

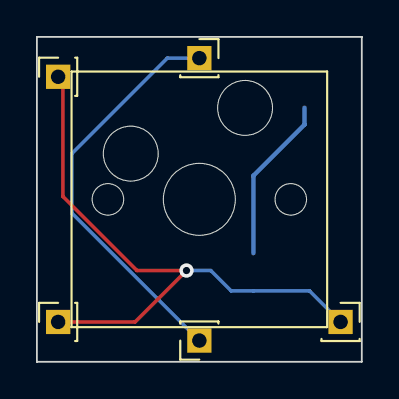
[picture p24: board onekeymod1u.kicad_pcb from above]

Board: 2 copper layers, 18.0 x 18.0 mm, 7 parts (1 on the bottom side), 3 nets.
