yuhao-kuo/goose45/(commit log)

2022-08-19 clean project
    * update sch from goose60
    [goose45.kicad_sch, matrix.kicad_sch]
2022-08-20 update key switch location on pcb
    [Interface.kicad_sch, PowerManager.kicad_sch, goose45.kicad_pcb, goose45.kicad_sch, switches.kicad_sch]
2022-10-07 clean project
    [Interface.kicad_sch, PowerManager.kicad_sch, goose45.kicad_pcb, goose45.kicad_sch, switches.kicad_sch]
2022-10-07 add submodule keyswitch-kicad-library
2022-10-13 Update lib and rewrite PCB layout
    [goose45.kicad_pcb, goose45.kicad_sch, interface.kicad_sch, power_manager.kicad_sch, switchs.kicad_sch]
2022-10-13 fix PCB GND issue
    [goose45.kicad_pcb]
2022-10-14 update PCB layout
    [goose45.kicad_pcb, goose45.kicad_sch, switchs.kicad_sch]
2022-10-15 add GND via and update PCB height
    [goose45.kicad_pcb]
2022-10-16 move the PCB project to goose45rev1
    [goose45.kicad_pcb, goose45.kicad_sch, interface.kicad_sch, power_manager.kicad_sch, switchs.kicad_sch]
2022-10-18 remove the usb conn on rev1
    [goose45.kicad_pcb, goose45.kicad_sch, interface.kicad_sch]
2022-10-19 update usb layout and add connector
    [goose45.kicad_pcb, goose45.kicad_sch, interface.kicad_sch]
2022-10-22 change Diode pcb pad and modify usb connector location
    [goose45.kicad_pcb, goose45.kicad_sch, interface.kicad_sch, power_manager.kicad_sch, switchs.kicad_sch]
2022-10-23 update 3D model
    [goose45.kicad_pcb]
2022-11-04 update goose45 pcb usb pad and crystal
    [goose45.kicad_pcb, goose45.kicad_sch, interface.kicad_sch]
2022-11-10 add usbhub board
    [usbhub.kicad_pcb, usbhub.kicad_sch]
2022-11-12 add 1u key switch mod pcb board
    [onekeymod1u.kicad_pcb, onekeymod1u.kicad_sch, usbhub.kicad_pcb]
2022-11-21 Change goose45 mod key size
    [goose45.kicad_pcb, goose45.kicad_sch, switchs.kicad_sch, usbhub.kicad_pcb]
2022-12-05 update pcb
    [goose45.kicad_pcb, usbhub.kicad_pcb]
2022-12-24 change usb2.0 hub board design
    [usbhub.kicad_pcb, usbhub.kicad_sch]
2022-12-24 change goose45 main board edge.cuts
    [goose45.kicad_pcb]
2022-12-25 add usb 2.0 type-c board
    [usbc2.0.kicad_pcb, usbc2.0.kicad_sch]
2022-12-25 add usb port board
    [usbport.kicad_pcb, usbport.kicad_sch]
2022-12-26 change pcb thickness and add ubhc 3d step file
    [usbc2.0.kicad_pcb, usbhub2.0.kicad_pcb, usbport.kicad_pcb]
2022-12-30 change usbhub2.0 board design
    * remove usb molex input and add usb-c to input channel
    * change usbout1 molex to pin header
    [usbhub2.0.kicad_pcb, usbhub2.0.kicad_sch]
2022-12-31 update goose45 pcb board edge comment
    * goose45 - update board layout
    * usbport - change edge size and add edge comment
    * usbhub2.0 - change layout and the footprint
    [goose45.kicad_pcb, usbhub2.0.kicad_pcb, usbport.kicad_pcb]
2023-01-13 update pcb common and update goose45 key loaction
    [goose45.kicad_pcb, goose45.kicad_sch, switchs.kicad_sch, usbhub2.0.kicad_pcb, usbport.kicad_pcb]
2023-01-16 update usb type-c 3d model
    [goose45.kicad_pcb, usbhub2.0.kicad_pcb]
2023-01-21 remove goose45 pcb usb type-c
    [goose45.kicad_pcb, goose45.kicad_sch, interface.kicad_sch]
2023-01-21 update goose45 pcb comments
    [goose45.kicad_pcb]
2023-01-23 add goose45 case
    [goose45case_bottom_v6.FCStd, goose45case_class_v6.FCStd, goose45case_group.FCStd, goose45case_plate_v6.FCStd, goose45case_top_v6.FCStd]
2023-01-24 change goose45 pcb board edge
    [goose45.kicad_pcb]
2023-01-24 update goose45 group cad
    [goose45case_group.FCStd]
2023-02-04 update bottom case v6
    [goose45case_bottom_v6.FCStd, goose45case_group.FCStd]
2023-02-12 change goose45 power module foodpoint
    [goose45.kicad_pcb, goose45.kicad_sch, power_manager.kicad_sch]
2023-02-15 update goose45case version to v7
    [goose45case_bottom_v6.FCStd, goose45case_bottom_v7.FCStd, goose45case_class_v6.FCStd, goose45case_class_v7.FCStd, goose45case_group.FCStd, goose45case_plate_v6.FCStd, goose45case_plate_v7.FCStd, goose45case_top_v6.FCStd]
2023-03-04 update usbport pcb edge size comments
    [usbport.kicad_pcb]
2023-03-04 update goose45case class usbport design
    [goose45case_class_v8.FCStd]
2023-03-30 modify the usbhub2.0 board edge
    [usbhub2.0.kicad_pcb]
2023-04-01 Update case design to version 9
    [goose45case_bottom_v9.FCStd, goose45case_class_v9.FCStd, goose45case_plate_v9.FCStd, goose45case_top_v9.FCStd]
2023-04-01 update usbhub 2.0 board edge size and the comment
    [usbhub2.0.kicad_pcb]
2023-05-23 update plate
    [goose45case_plate_v9.FCStd]
2023-10-07 add goose45rev2 pcb
    [goose45.kicad_pcb, goose45.kicad_sch, interface.kicad_sch, power_manager.kicad_sch, switchs.kicad_sch]
2023-12-04 add usbhub2.0 rev2
    [usbhub2.0rev2.kicad_pcb, usbhub2.0rev2.kicad_sch]
2023-12-09 add goose45 rev3 and usbhub2.3 rev2
    [goose45.kicad_pcb, goose45.kicad_sch, interface.kicad_sch, power_manager.kicad_sch, switchs.kicad_sch, usbhub2.0rev2.kicad_pcb]
2023-12-30 add goose45 case v10 and update sub-usb pcb
    [goose45case_bottom_v10.FCStd, goose45case_class_v10.FCStd, goose45case_plate_v10.FCStd, goose45case_top_v10.FCStd, usbhub2.0.kicad_pcb, usbhub2.0.kicad_sch, usbport.kicad_pcb, usbport.kicad_sch]
